jorisplusplus/HA_Knob/bom.ods

Product | Count | Link
40mm glass, 1mm thick | 1 | https://www.aliexpress.com/item/1005003243322308.html
M2x2 flathead screw | 4 | https://www.aliexpress.com/item/32995858149.html
M2.5x25 hex hollow standoff | 1 | https://nl.aliexpress.com/item/1005002348335932.html
M1.6x4 | 4 | https://nl.aliexpress.com/item/32996895870.html
Several high temperature structure glue | 1 | x
502 glue several | 1 | x
M2 height 6.6 Flying control shock absorbing column | 4 | https://nl.aliexpress.com/item/1005002855654361.html
M2*12 Inner hexagonal and half -teeth screws | 4 | https://nl.aliexpress.com/item/1005001578643599.html
Point 0.8mm 8P 32AWG single line | 1 | https://nl.aliexpress.com/item/4001089049756.html
M2*5 screw | 3 | https://www.aliexpress.com/item/32995858149.html
3205 motor A model infinite position | 1 | x
2P DuPont Line Affordable length | 1 | x
602535 Lithium battery 600mAh | 1 | https://nl.aliexpress.com/item/1005004340661125.html
0.15mm double -sided glue moderate amount | 1 | https://nl.aliexpress.com/item/1005004473169787.html
FPC soft antenna IPEX 1st generation | 1 | https://www.lcsc.com/product-detail/_DreamLNK-_C403726.html
A non -slip silicone pad about 54mm diameter | 1
M2.5*5 screw | 1
FFC cable 14 pos, 0.5mm pitch 30 and 50mm length | 1 | C2857705 C5151981 C5151957 C2857490
