jorisplusplus/HA_Knob/hardware/motor_pcb/motor_pcb.kicad_pcb

## KiCad design hardware/motor_pcb/motor_pcb.kicad_pcb (2023-03-04)

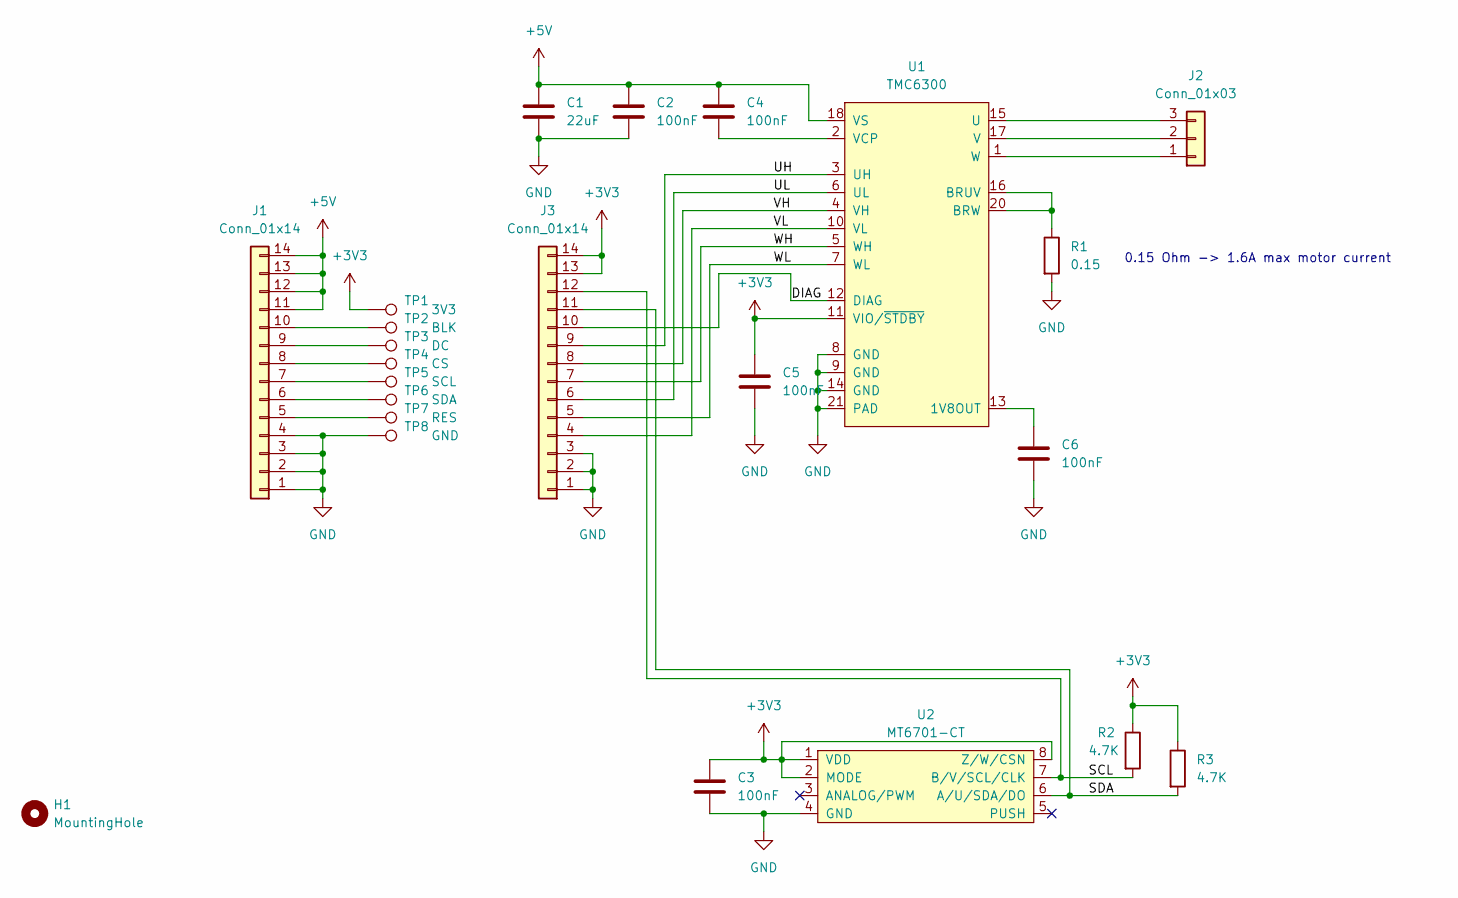
[picture p1: schematic motor_pcb.kicad_sch]

Parts:
C1: 22uF; C_0805_2012Metric; LCSC C45783
C2, C3, C4, C5, C6: 100nF; C_0603_1608Metric; LCSC C14663
H1: MountingHole; Holes
J1, J3: Conn_01x14; FPC_14; LCSC C262561
J2: Conn_01x03; Hirose_DF52-3S-0.8H_1x03-1MP_P0.80mm_Horizontal; LCSC C500138
R1: 0.15; R_1206_3216Metric; LCSC C37936
R2, R3: 4.7K; R_0603_1608Metric; LCSC C23162
TP1: 3V3; TestPoint_Pad_2.0x2.0mm
TP2: BLK; TestPoint_Pad_2.0x2.0mm
TP3: DC; TestPoint_Pad_2.0x2.0mm
TP4: CS; TestPoint_Pad_2.0x2.0mm
TP5: SCL; TestPoint_Pad_2.0x2.0mm
TP6: SDA; TestPoint_Pad_2.0x2.0mm
TP7: RES; TestPoint_Pad_2.0x2.0mm
TP8: GND; TestPoint_Pad_2.0x2.0mm
U1: TMC6300; QFN-20-1EP_3x3mm_P0.4mm_EP1.65x1.65mm_ThermalVias
U2: MT6701-CT; SOIC-8_3.9x4.9mm_P1.27mm; LCSC C2856764

Connections:
+3V3: C3.1, C5.1, J3.13, J3.14, R2.1, R3.1, TP1.1, U1.11 (VIO/~STDBY), U2.1 (VDD), U2.2 (MODE), U2.8 (Z/W/CSN)
+5V: C1.1, C2.1, C4.1, J1.11, J1.12, J1.13, J1.14, U1.18 (VS)
/DIAG: J3.10, U1.12 (DIAG)
/SCL: J3.12, R2.2, U2.7 (B/V/SCL/CLK)
/SDA: J3.11, R3.2, U2.6 (A/U/SDA/DO)
/UH: J3.9, U1.3 (UH)
/UL: J3.6, U1.6 (UL)
/VH: J3.8, U1.4 (VH)
/VL: J3.4, U1.10 (VL)
/WH: J3.7, U1.5 (WH)
/WL: J3.5, U1.7 (WL)
GND: C1.2, C2.2, C3.2, C5.2, C6.2, J1.1, J1.2, J1.3, J1.4, J3.1, J3.2, J3.3, R1.2, TP8.1, U1.8 (GND), U1.9 (GND), U1.14 (GND), U1.21 (PAD), U2.4 (GND)
unnamed: C4.2, U1.2 (VCP)
unnamed: C6.1, U1.13 (1V8OUT)
unnamed: J1.5, TP7.1
unnamed: J1.6, TP6.1
unnamed: J1.7, TP5.1
unnamed: J1.8, TP4.1
unnamed: J1.9, TP3.1
unnamed: J1.10, TP2.1
unnamed: J2.1, U1.1 (W)
unnamed: J2.2, U1.17 (V)
unnamed: J2.3, U1.15 (U)
unnamed: R1.1, U1.16 (BRUV), U1.20 (BRW)

Notes on the sheet:
0.15 Ohm -> 1.6A max motor current

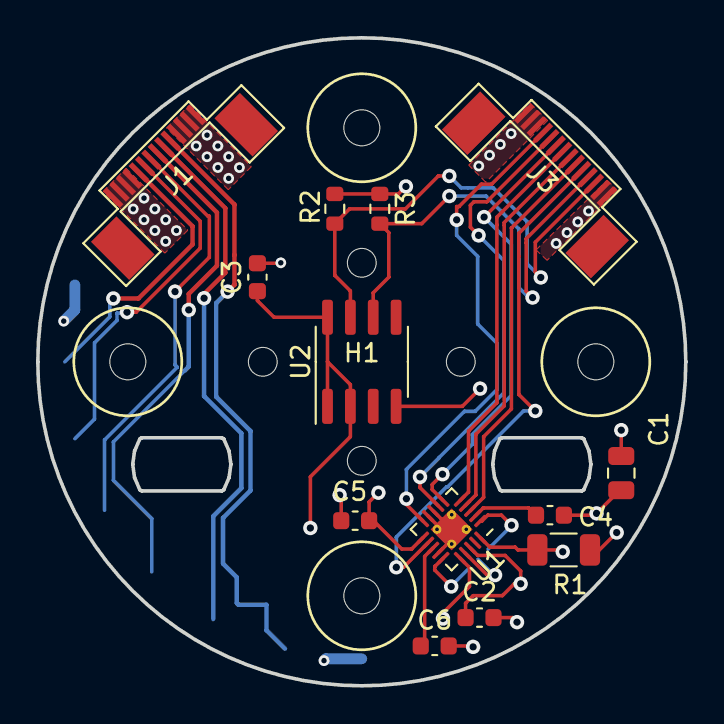
[picture p2: board motor_pcb.kicad_pcb from above]

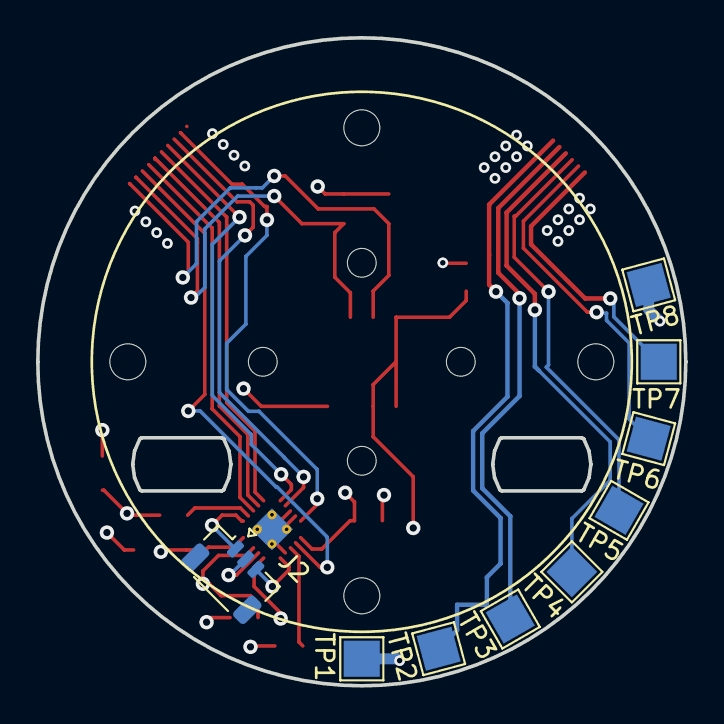
[picture p3: board motor_pcb.kicad_pcb from below]

Board: 4 copper layers, 36.0 x 36.0 mm, 23 parts (9 on the bottom side), 24 nets.
