jorisplusplus/HA_Knob/hardware/main_pcb/main_pcb.kicad_pcb

## KiCad design hardware/main_pcb/main_pcb.kicad_pcb (2023-01-07)

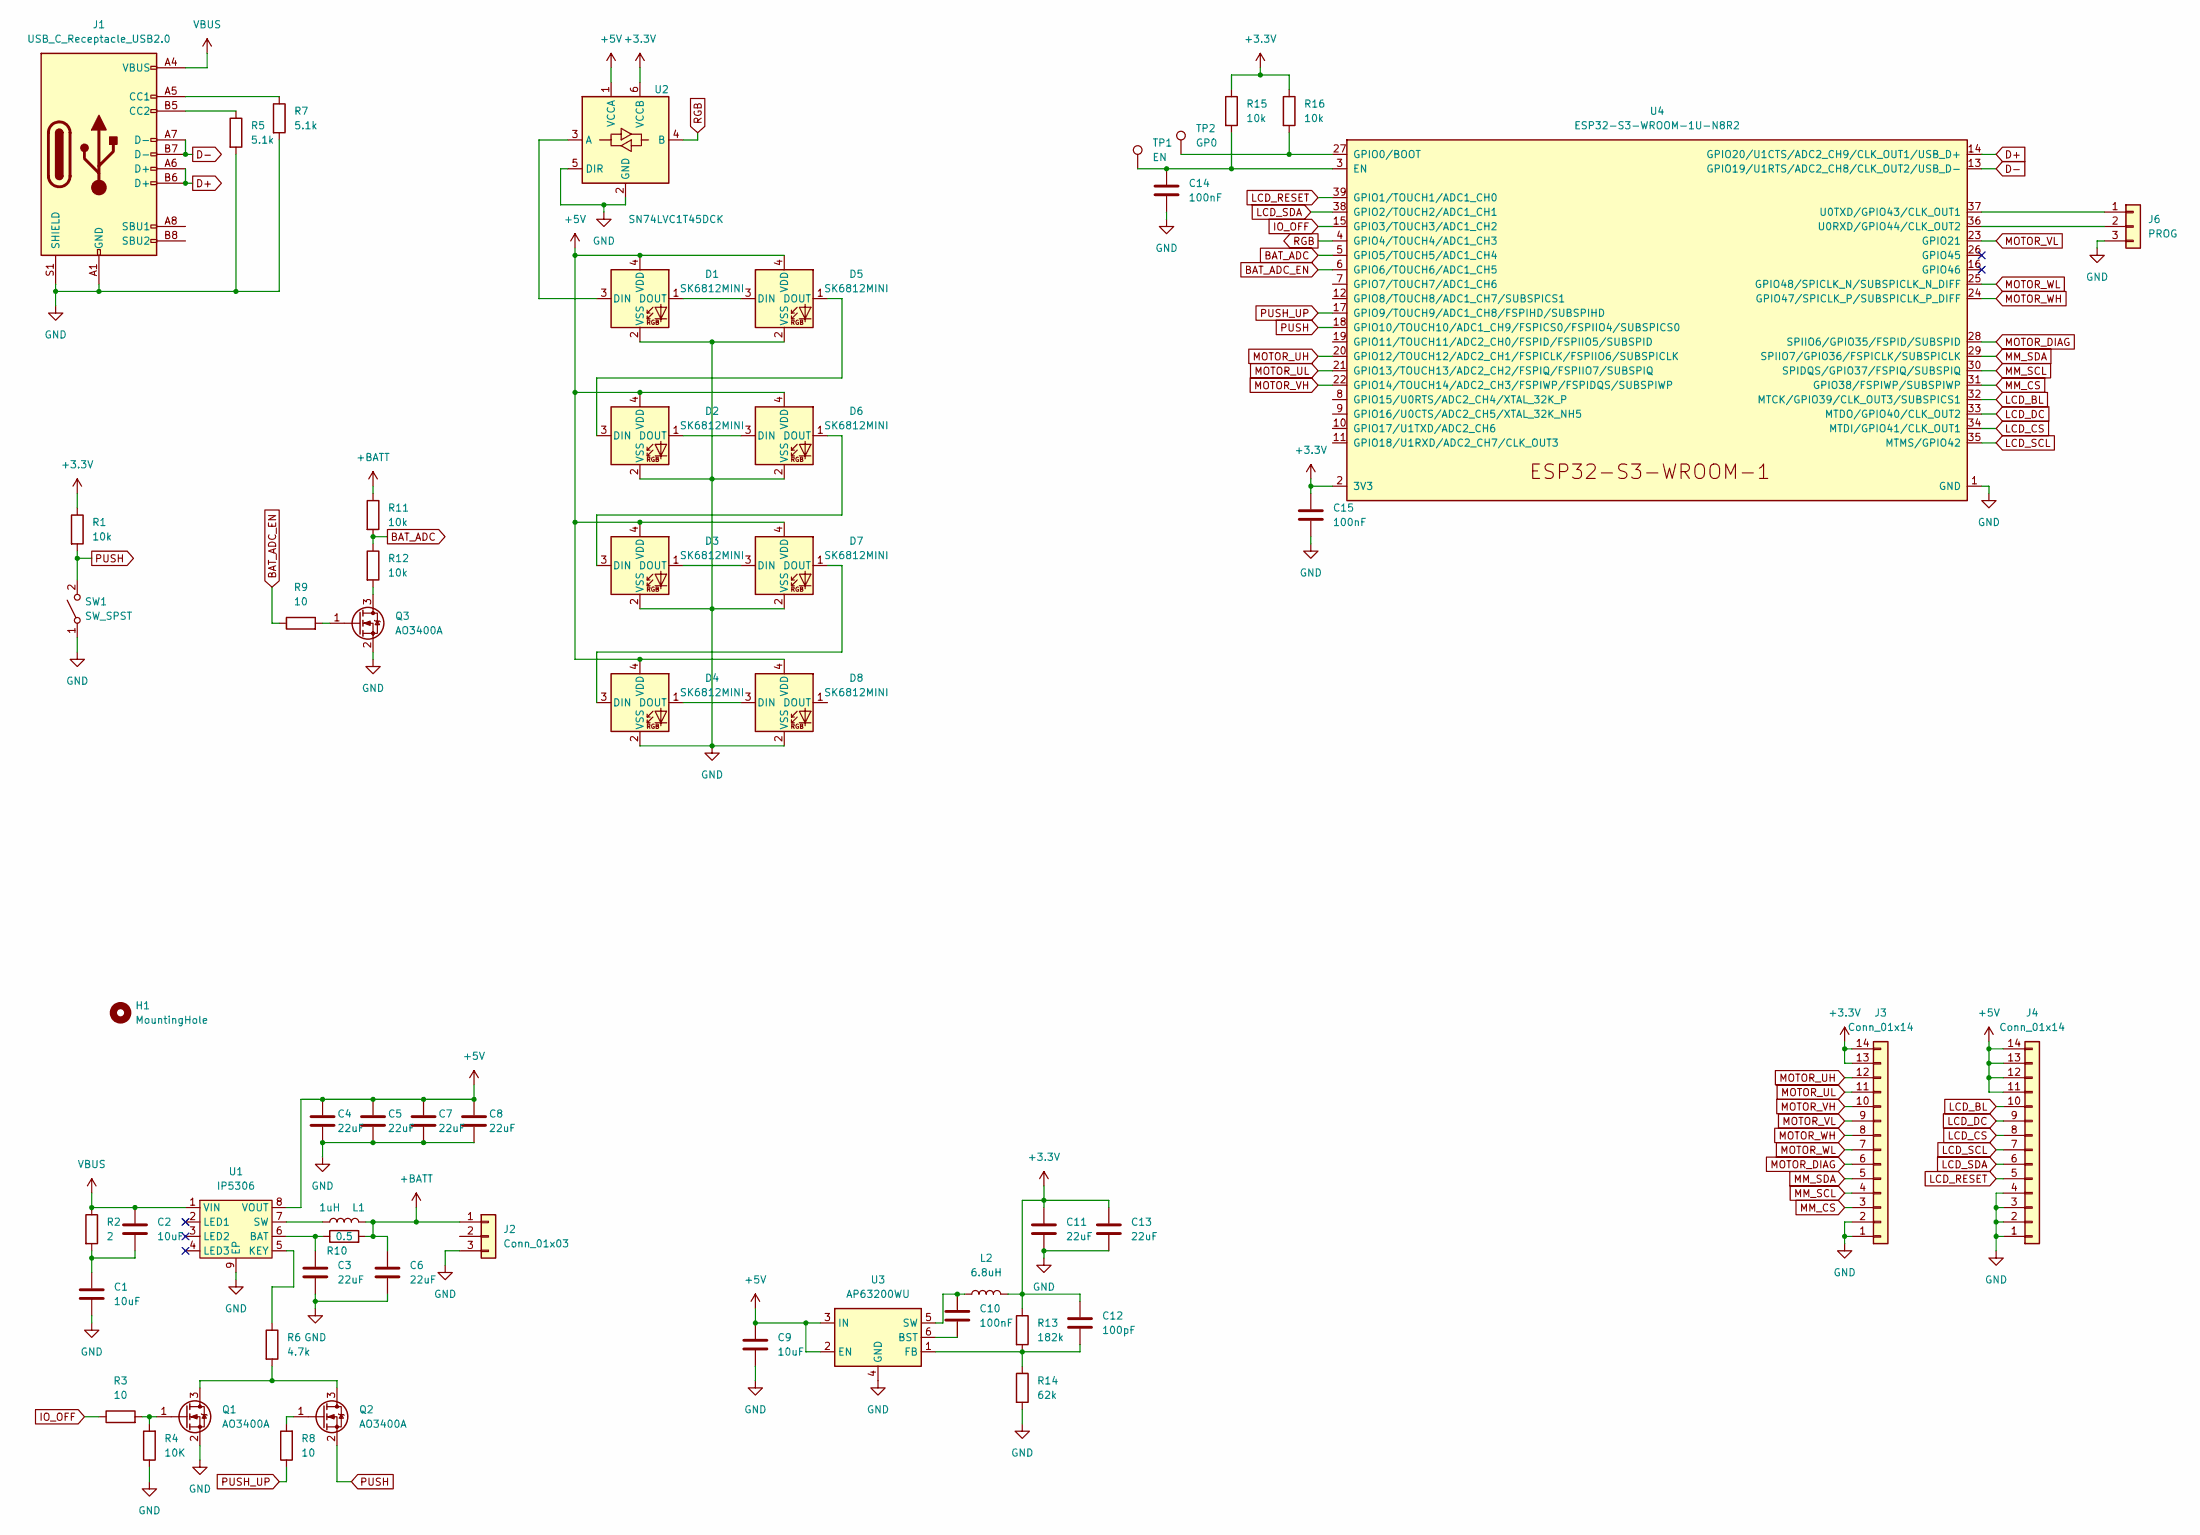
[picture p4: schematic main_pcb.kicad_sch]

Parts:
C1, C2, C9: 10uF; C_0603_1608Metric
C3, C4, C5, C6, C7, C8, C11, C13: 22uF; C_0805_2012Metric
C10, C14, C15: 100nF; C_0603_1608Metric
C12: 100pF; C_0603_1608Metric
D1, D2, D3, D4, D5, D6, D7, D8: SK6812MINI; LED_SK6812MINI_PLCC4_3.5x3.5mm_P1.75mm
H1: MountingHole; holes
J1: USB_C_Receptacle_USB2.0; USB_C_Receptacle_HRO_TYPE-C-31-M-12; LCSC C165948
J2: Conn_01x03; Molex_PicoBlade_53261-0371_1x03-1MP_P1.25mm_Horizontal
J3, J4: Conn_01x14; FPC_14; LCSC C262561
J6: PROG; PinHeader_1x03_P2.54mm_Vertical
L1: 1uH; MWSA0402S-6R8MT; LCSC C408332
L2: 6.8uH; MWSA0402S-6R8MT; LCSC C408338
Q1, Q2, Q3: AO3400A; SOT-23
R1, R11, R12, R15, R16: 10k; R_0603_1608Metric
R2: 2; R_0603_1608Metric
R3, R8, R9: 10; R_0603_1608Metric
R4: 10K; R_0603_1608Metric
R5, R7: 5.1k; R_0603_1608Metric
R6: 4.7k; R_0603_1608Metric
R10: 0.5; R_0603_1608Metric
R13: 182k; R_0603_1608Metric
R14: 62k; R_0603_1608Metric
SW1: SW_SPST; TS-1068A-A2B3-D2; LCSC C498297
TP1: EN; TestPoint_Pad_D2.0mm
TP2: GP0; TestPoint_Pad_D2.0mm
U1: IP5306; SOP-8-1EP_4.57x4.57mm_P1.27mm_EP4.57x4.45mm_ThermalVias
U2: SN74LVC1T45DCK; SOT-363_SC-70-6
U3: AP63200WU; TSOT-23-6
U4: ESP32-S3-WROOM-1U-N8R2; ESP32-S3-WROOM-1U

Connections:
+3.3V: C11.1, C12.1, C13.1, C15.1, J3.13, J3.14, L2.2, R1.1, R13.1, R15.1, R16.1, U2.6 (VCCB), U4.2 (3V3)
+5V: C4.1, C5.1, C7.1, C8.1, C9.1, D1.4 (VDD), D2.4 (VDD), D3.4 (VDD), D4.4 (VDD), D5.4 (VDD), D6.4 (VDD), D7.4 (VDD), D8.4 (VDD), J4.11, J4.12, J4.13, J4.14, U1.8 (VOUT), U2.1 (VCCA), U3.2 (EN), U3.3 (IN)
+BATT: C6.1, J2.1, L1.2, R10.2, R11.1
BAT_ADC: R11.2, R12.1, U4.5 (GPIO5/TOUCH5/ADC1_CH4)
BAT_ADC_EN: R9.1, U4.6 (GPIO6/TOUCH6/ADC1_CH5)
D+: J1.A6 (D+), J1.B6 (D+), U4.14 (GPIO20/U1CTS/ADC2_CH9/CLK_OUT1/USB_D+)
D-: J1.A7 (D-), J1.B7 (D-), U4.13 (GPIO19/U1RTS/ADC2_CH8/CLK_OUT2/USB_D-)
GND: C1.2, C3.2, C4.2, C5.2, C6.2, C7.2, C8.2, C9.2, C11.2, C13.2, C14.2, C15.2, D1.2 (VSS), D2.2 (VSS), D3.2 (VSS), D4.2 (VSS), D5.2 (VSS), D6.2 (VSS), D7.2 (VSS), D8.2 (VSS), J1.A1 (GND), J1.A12 (GND), J1.B1 (GND), J1.B12 (GND), J1.S1 (SHIELD), J2.3, J3.1, J3.2, J4.1, J4.2, J4.3, J4.4, J6.3, Q1.2 (S), Q3.2 (S), R4.1, R5.2, R7.2, R14.2, SW1.1 (A), U1.9 (EP), U2.2 (GND), U2.5 (DIR), U3.4 (GND), U4.1 (GND), U4.40 (GND), U4.41 (GND)
IO_OFF: R3.1, U4.15 (GPIO3/TOUCH3/ADC1_CH2)
LCD_BL: J4.10, U4.32 (MTCK/GPIO39/CLK_OUT3/SUBSPICS1)
LCD_CS: J4.8, U4.34 (MTDI/GPIO41/CLK_OUT1)
LCD_DC: J4.9, U4.33 (MTDO/GPIO40/CLK_OUT2)
LCD_RESET: J4.5, U4.39 (GPIO1/TOUCH1/ADC1_CH0)
LCD_SCL: J4.7, U4.35 (MTMS/GPIO42)
LCD_SDA: J4.6, U4.38 (GPIO2/TOUCH2/ADC1_CH1)
MM_CS: J3.3, U4.31 (GPIO38/FSPIWP/SUBSPIWP)
MM_SCL: J3.4, U4.30 (SPIDQS/GPIO37/FSPIQ/SUBSPIQ)
MM_SDA: J3.5, U4.29 (SPIIO7/GPIO36/FSPICLK/SUBSPICLK)
MOTOR_DIAG: J3.6, U4.28 (SPIIO6/GPIO35/FSPID/SUBSPID)
MOTOR_UH: J3.12, U4.20 (GPIO12/TOUCH12/ADC2_CH1/FSPICLK/FSPIIO6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)
MOTOR_UL: J3.11, U4.21 (GPIO13/TOUCH13/ADC2_CH2/FSPIQ/FSPIIO7/S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)
MOTOR_VH: J3.10, U4.22 (GPIO14/TOUCH14/ADC2_CH3/FSPIWP/FSPIDQS/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)
MOTOR_VL: J3.9, U4.23 (GPIO21)
MOTOR_WH: J3.8, U4.24 (GPIO47/SPICLK_P/SUBSPICLK_P_DIFF)
MOTOR_WL: J3.7, U4.25 (GPIO48/SPICLK_N/SUBSPICLK_N_DIFF)
unnamed: C1.1, C2.2, R2.2
unnamed: C3.1, R10.1, U1.6 (BAT)
unnamed: C10.1, L2.1, U3.5 (SW)
unnamed: C10.2, U3.6 (BST)
unnamed: C12.2, R13.2, R14.1, U3.1 (FB)
unnamed: C14.1, R15.2, TP1.1, U4.3 (EN)
unnamed: D1.1 (DOUT), D5.3 (DIN)
unnamed: D1.3 (DIN), U2.3 (A)
unnamed: D2.1 (DOUT), D6.3 (DIN)
unnamed: D2.3 (DIN), D5.1 (DOUT)
unnamed: D3.1 (DOUT), D7.3 (DIN)
unnamed: D3.3 (DIN), D6.1 (DOUT)
unnamed: D4.1 (DOUT), D8.3 (DIN)
unnamed: D4.3 (DIN), D7.1 (DOUT)
unnamed: J1.A5 (CC1), R7.1
unnamed: J1.B5 (CC2), R5.1
unnamed: J6.1, U4.37 (U0TXD/GPIO43/CLK_OUT1)
unnamed: J6.2, U4.36 (U0RXD/GPIO44/CLK_OUT2)
unnamed: L1.1, U1.7 (SW)
unnamed: Q1.1 (G), R3.2, R4.2
unnamed: Q1.3 (D), Q2.3 (D), R6.2
unnamed: Q2.1 (G), R8.2
unnamed: Q3.1 (G), R9.2
unnamed: Q3.3 (D), R12.2
unnamed: R6.1, U1.5 (KEY)
unnamed: R16.2, TP2.1, U4.27 (GPIO0/BOOT)
PUSH: Q2.2 (S), R1.2, SW1.2 (B), U4.18 (GPIO10/TOUCH10/ADC1_CH9/FSPICS0/FSPIIO4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)
PUSH_UP: R8.1, U4.17 (GPIO9/TOUCH9/ADC1_CH8/FSPIHD/SUBSPIHD)
RGB: U2.4 (B), U4.4 (GPIO4/TOUCH4/ADC1_CH3)
VBUS: C2.1, J1.A4 (VBUS), J1.A9 (VBUS), J1.B4 (VBUS), J1.B9 (VBUS), R2.1, U1.1 (VIN)

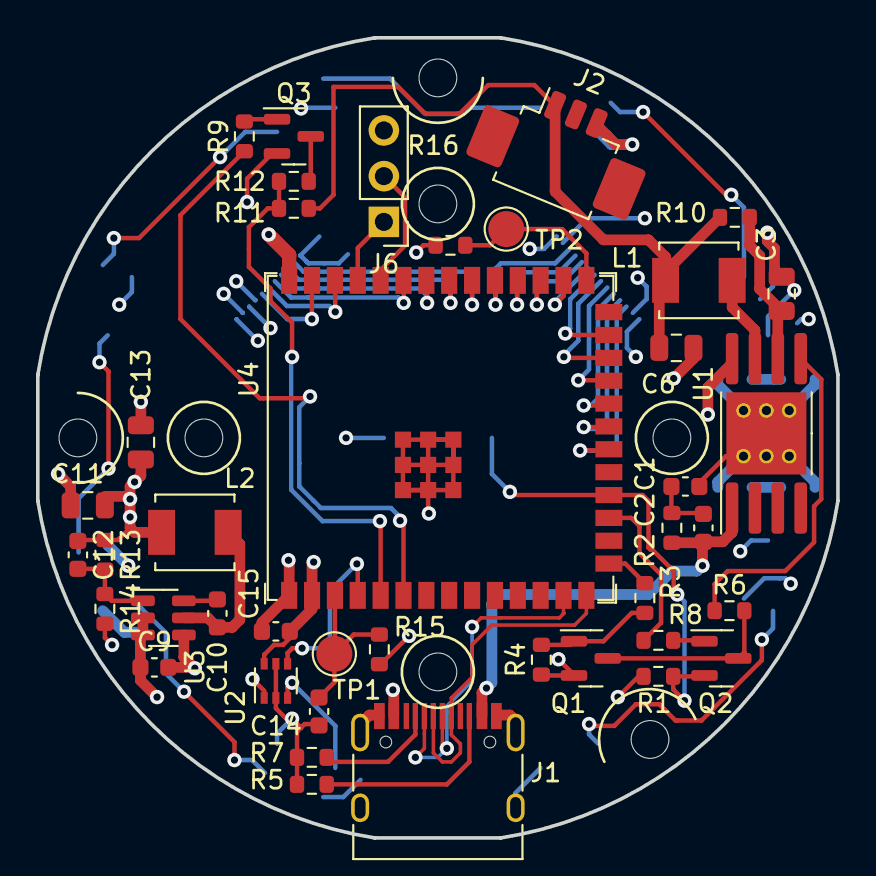
[picture p5: board main_pcb.kicad_pcb from above]

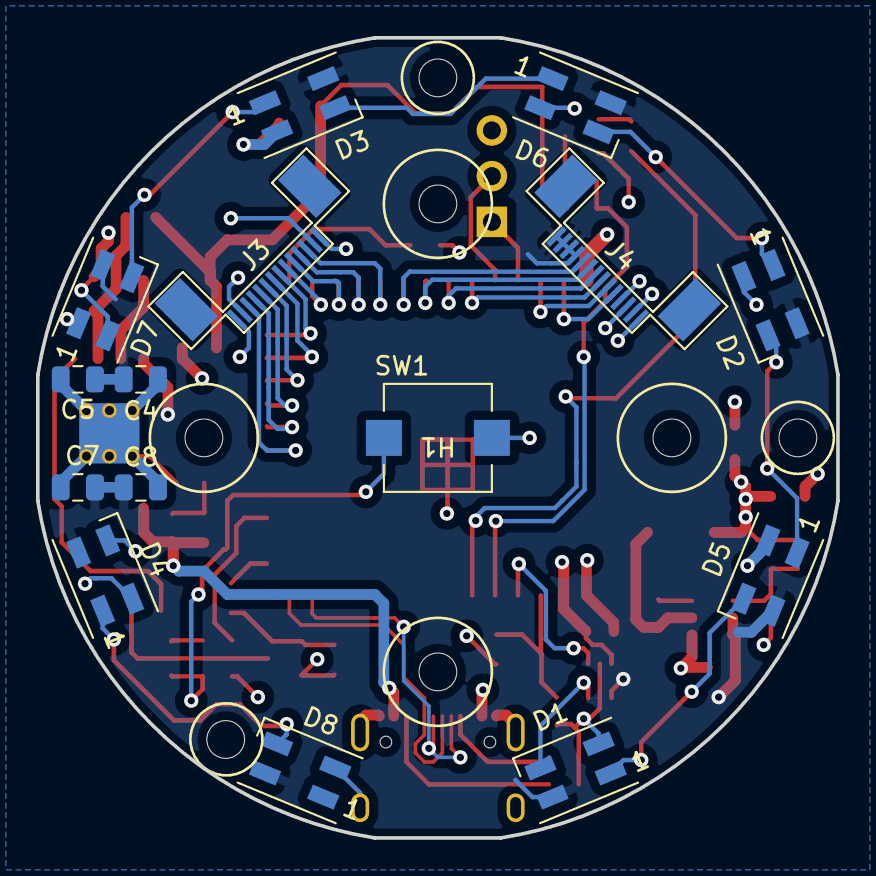
[picture p6: board main_pcb.kicad_pcb from below]

Board: 4 copper layers, 44.5 x 44.5 mm, 57 parts (16 on the bottom side), 55 nets.
