jorisplusplus/HA_Knob/hardware/lcd_pcb/lcd_pcb.kicad_pcb

## KiCad design hardware/lcd_pcb/lcd_pcb.kicad_pcb (2022-12-25)

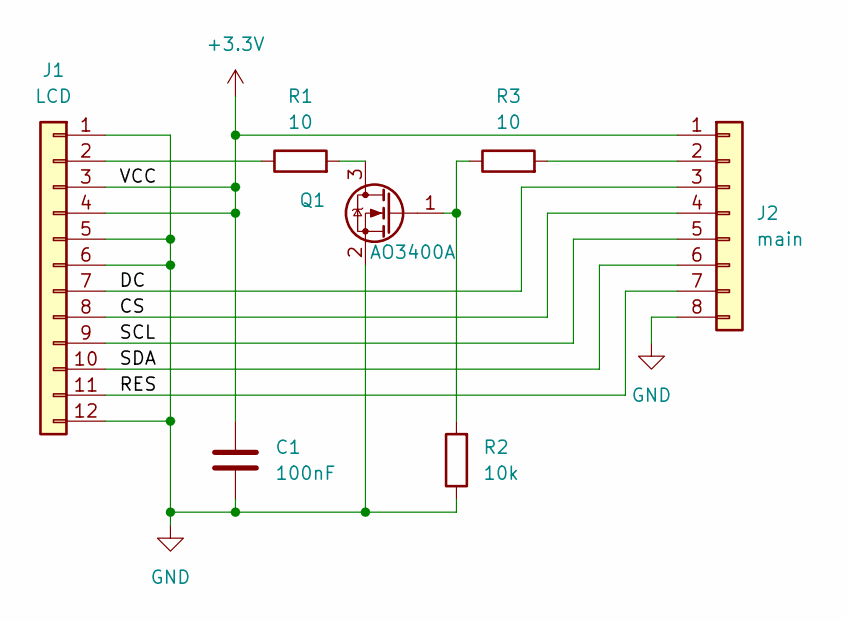
[picture p7: schematic lcd_pcb.kicad_sch]

Parts:
C1: 100nF; C_0603_1608Metric
J1: LCD; GC9A01Round1.28
J2: main; Hirose_DF52-8S-0.8H_1x08-1MP_P0.80mm_Horizontal
Q1: AO3400A; SOT-23
R1, R3: 10; R_0603_1608Metric
R2: 10k; R_0603_1608Metric

Connections:
+3.3V: C1.1, J1.3, J1.4, J2.1
/CS: J1.8, J2.4
/DC: J1.7, J2.3
/RES: J1.11, J2.7
/SCL: J1.9, J2.5
/SDA: J1.10, J2.6
GND: C1.2, J1.1, J1.5, J1.6, J1.12, J2.8, Q1.2 (S), R2.1
unnamed: J1.2, R1.1
unnamed: J2.2, R3.2
unnamed: Q1.1 (G), R2.2, R3.1
unnamed: Q1.3 (D), R1.2

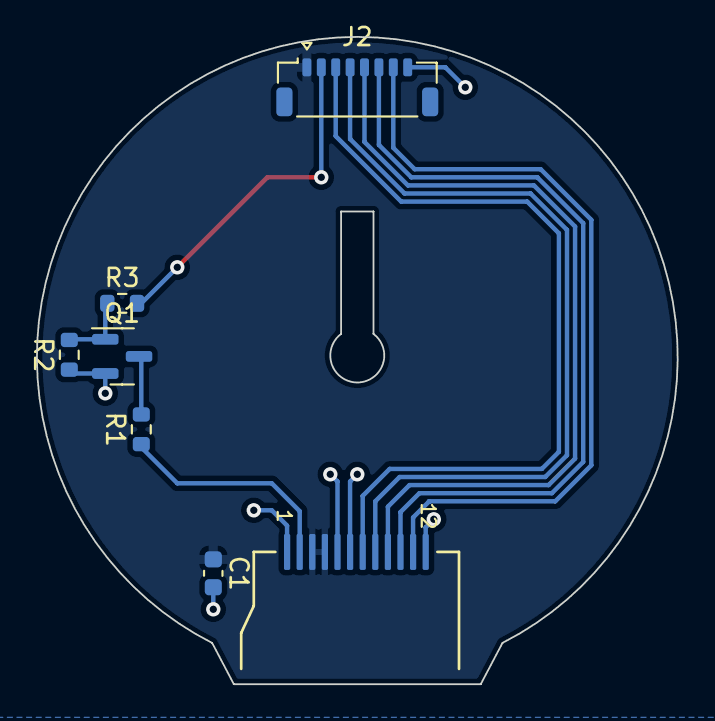
[picture p8: board lcd_pcb.kicad_pcb from below]

Board: 2 copper layers, 35.6 x 36.0 mm, 7 parts (7 on the bottom side), 11 nets.
