jorisplusplus/HA_Knob/firmware/HAKnob/main/HAKnob.c

#include <stdio.h>
#include <esp_log.h>
#include "config.h"
#include "driver/i2c.h"
#include "driver/spi_master.h"
#include "driver/gpio.h"
#include "esp_lcd_panel_io.h"
#include "esp_lcd_panel_vendor.h"
#include "esp_lcd_panel_ops.h"
#include "esp_lcd_gc9a01.h"
#include <freertos/FreeRTOS.h>
#include "motor.h"

#define TAG "MAIN"

#define I2C_MASTER_SCL_IO           GPIO_MM_SCL      /*!< GPIO number used for I2C master clock */
#define I2C_MASTER_SDA_IO           GPIO_MM_SDA      /*!< GPIO number used for I2C master data  */
#define I2C_MASTER_NUM              0                          /*!< I2C master i2c port number, the number of i2c peripheral interfaces available will depend on the chip */
#define I2C_MASTER_FREQ_HZ          1000000                     /*!< I2C master clock frequency */
#define I2C_MASTER_TX_BUF_DISABLE   0                          /*!< I2C master doesn't need buffer */
#define I2C_MASTER_RX_BUF_DISABLE   0                          /*!< I2C master doesn't need buffer */
#define I2C_MASTER_TIMEOUT_MS       1000
#define LCD_HOST    SPI2_HOST
#define MM_ADDRESS 0b0000110


//This function is called (in irq context!) just before a transmission starts. It will
//set the D/C line to the value indicated in the user field.
void lcd_spi_pre_transfer_callback(spi_transaction_t *t)
{
    int dc=(int)t->user;
    gpio_set_level(GPIO_LCD_DC, dc);
}


void app_main(void)
{
    ESP_LOGI(TAG, "I2C initialized successfully");
    ESP_LOGI(TAG, "Turn off LCD backlight");
    gpio_config_t bk_gpio_config = {
        .mode = GPIO_MODE_OUTPUT,
        .pin_bit_mask = 1ULL << GPIO_LCD_BL
    };
    ESP_ERROR_CHECK(gpio_config(&bk_gpio_config));

    motor_init();
    esp_err_t ret;
    spi_bus_config_t buscfg={
        .miso_io_num=-1,
        .mosi_io_num=GPIO_LCD_SDA,
        .sclk_io_num=GPIO_LCD_SCL,
        .quadwp_io_num=-1,
        .quadhd_io_num=-1,
        .max_transfer_sz=240*240*2+8
    };
    esp_lcd_panel_io_handle_t io_handle = NULL;
    esp_lcd_panel_io_spi_config_t io_config = {
        .dc_gpio_num = GPIO_LCD_DC,
        .cs_gpio_num = GPIO_LCD_CS,
        .pclk_hz = 1000000,
        .lcd_cmd_bits = 8,
        .lcd_param_bits = 8,
        .spi_mode = 0,
        .trans_queue_depth = 10,
    };
    ret=spi_bus_initialize(LCD_HOST, &buscfg, SPI_DMA_CH_AUTO);
    ESP_ERROR_CHECK(ret);
    //Attach the LCD to the SPI bus
    ESP_ERROR_CHECK(esp_lcd_new_panel_io_spi((esp_lcd_spi_bus_handle_t)LCD_HOST, &io_config, &io_handle));
    ESP_LOGI(TAG, "Install GC9A01 panel driver");


    esp_lcd_panel_handle_t panel_handle = NULL;
    esp_lcd_panel_dev_config_t panel_config = {
        .reset_gpio_num = GPIO_LCD_RESET,
        .rgb_endian = LCD_RGB_ENDIAN_BGR,
        .bits_per_pixel = 16,
    };

    ESP_ERROR_CHECK(esp_lcd_new_panel_gc9a01(io_handle, &panel_config, &panel_handle));
    ESP_ERROR_CHECK(esp_lcd_panel_reset(panel_handle));
    ESP_ERROR_CHECK(esp_lcd_panel_init(panel_handle));
    ESP_ERROR_CHECK(esp_lcd_panel_invert_color(panel_handle, true));
    ESP_ERROR_CHECK(esp_lcd_panel_mirror(panel_handle, true, false));
    ESP_ERROR_CHECK(esp_lcd_panel_disp_on_off(panel_handle, true));
    gpio_set_level(GPIO_LCD_BL, 1);
    while (1) {
        vTaskDelay(10);
    }
}
