jorisplusplus/HA_Knob/(commit log)

2022-12-10 Added hardware folder
    [lcd_pcb.kicad_pcb, lcd_pcb.kicad_sch, main_pcb.kicad_pcb, main_pcb.kicad_sch, motor_pcb.kicad_pcb, motor_pcb.kicad_sch]
2022-12-10 Added schematic
    [lcd_pcb.kicad_sch]
2022-12-10 Initial motor schematic
    [motor_pcb.kicad_sch]
2022-12-10 Updated schematic
    [motor_pcb.kicad_sch]
2022-12-10 Updated power connector
    [motor_pcb.kicad_sch]
2022-12-10 Added footprint for lcd
    [lcd_pcb.kicad_pcb, lcd_pcb.kicad_sch]
2022-12-10 Updated main pcb design
    [main_pcb.kicad_pcb, main_pcb.kicad_sch]
2022-12-11 Added component footprints
    [main_pcb.kicad_pcb, main_pcb.kicad_sch]
2022-12-11 Switch to 4 layer pcb
    [main_pcb.kicad_pcb]
2022-12-11 Changed to fpc connector
    [motor_pcb.kicad_pcb, motor_pcb.kicad_sch]
2022-12-11 Updated lcsc number
    [motor_pcb.kicad_sch]
2022-12-12 Added bom
    [bom.ods]
2022-12-12 BOM update
    [bom.ods]
2022-12-13 Updated bom
    [bom.ods]
2022-12-13 Updated design with new wiring structure
    [motor_pcb.kicad_pcb, motor_pcb.kicad_sch]
2022-12-13 Updated connectors
    [main_pcb.kicad_pcb, main_pcb.kicad_sch, motor_pcb.kicad_pcb, motor_pcb.kicad_sch]
2022-12-16 Added footprint lcd
2022-12-19 Updated bom with new fpc
    [bom.ods]
2022-12-19 Updated battery connector
    [main_pcb.kicad_pcb, main_pcb.kicad_sch]
2022-12-20 Routed motor pcb
    [motor_pcb.kicad_pcb]
2022-12-20 Fixed stackup
    [motor_pcb.kicad_pcb]
2022-12-20 Finished routing
    [motor_pcb.kicad_sch]
2022-12-23 Fixed drc errors
    [motor_pcb.kicad_pcb]
2022-12-23 Added gerbers generates
2022-12-23 Install kicad
2022-12-25 Designed lcd pcb
    [lcd_pcb.kicad_pcb, lcd_pcb.kicad_sch]
2023-01-06 Initial route
    [main_pcb.kicad_pcb]
2023-01-07 Switched to debian
2023-01-07 Changed to kicad ppa
2023-03-04 Fixed routing
    [motor_pcb.kicad_pcb, motor_pcb.kicad_sch]
2023-04-16 Refactored motor driver
2023-05-09 Updated motor driver
2023-05-09 Increased control loop stability
    [motor.c]
2023-05-13 Changed PID and increased PWM
2023-06-01 Use spi
    [lcd_pcb.kicad_sch, motor_pcb.kicad_sch]
2023-06-01 Reduced spi speed
2023-06-01 Fixed wrap around averaging
    [motor.c]
2023-06-02 Updated PID values
2023-06-02 Add indent power support
2023-06-21 Fixed bug in indenting
    [motor.c, motorindent.c]
